ema-g72/Arduino_Geiger/Images/Capture.JPG

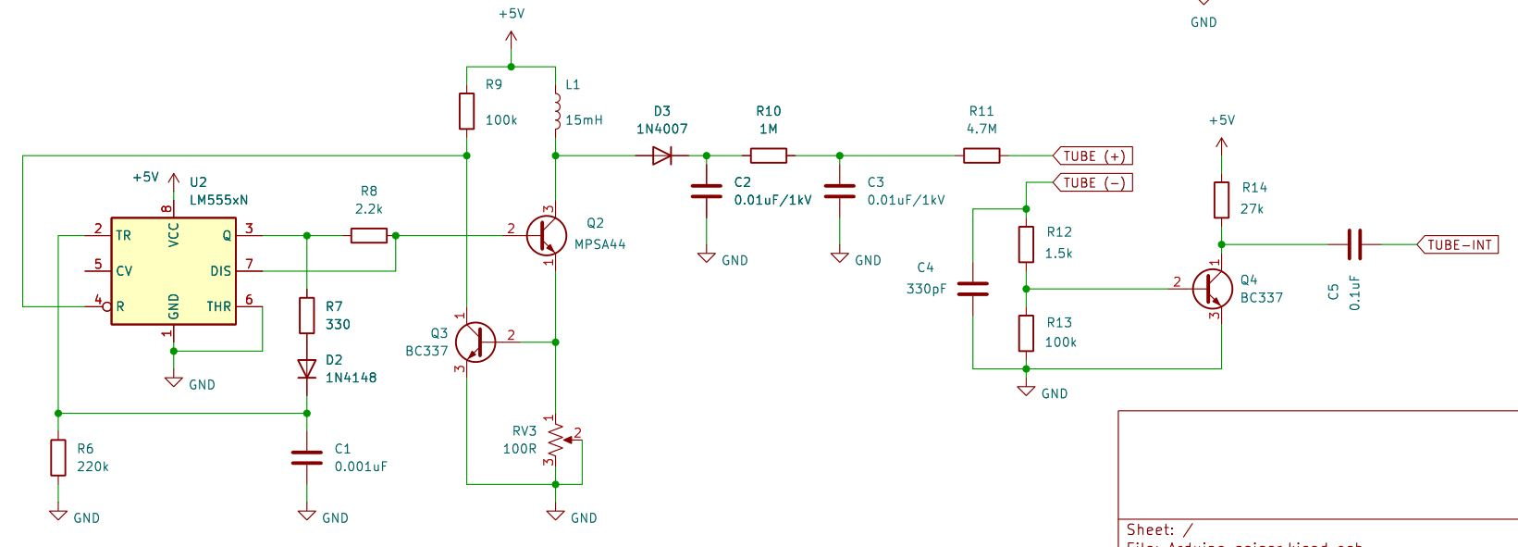
Images/Capture.JPG
